fontysrobotics/decentralized_cross_robot_communication_S7_2021_2022/README.md

# decentralized_cross_robot_communication_S7_2021_2022
Here the report, designs, test and code related to the S7 Decentralized cross robot communication
