fontysrobotics/decentralized_cross_robot_communication_S7_2021_2022/PCB/BOM_PCB_PCB_LED_beacon_dcrc_2022-02-03.csv

ID | Name | Designator | Footprint | Quantity | Manufacturer Part | Manufacturer | Supplier | Supplier Part | Price
1 | 1u | C1 | CASE-A_3216 | 1
2 | TC5050RGBF08-3CJH-AF53A | LED1,LED2,LED3,LED4,LED5,LED6,LED7,LED8,LED9,LED10,LED11,LED12,LED13,LED14 | LED-SMD_6P-L5.0-W5.0-TR_TC5050RGBF08 | 14 | TC5050RGBF08-3CJH-AF53A | TCWIN | LCSC | C784540 | 0.039
3 | 25.5 | R1,R2,R3,R4,R5,R6,R7,R8,R9,R14,R11,R12,R13,R10 | R0402 | 14 | 0402WGF255JTCE | Uniroyal Elec | LCSC | C129579 | 0.001
4 | DSIC10LH-P | SW1 | SW-TH_DSIC10LH-P | 1 | DSIC10LH-P | XKB Enterprise | LCSC | C381150 | 0.785
