fontysrobotics/decentralized_cross_robot_communication_S7_2021_2022/PCB/Schematic_PCB_LED_beacon_dcrc_2022-02-03.pdf

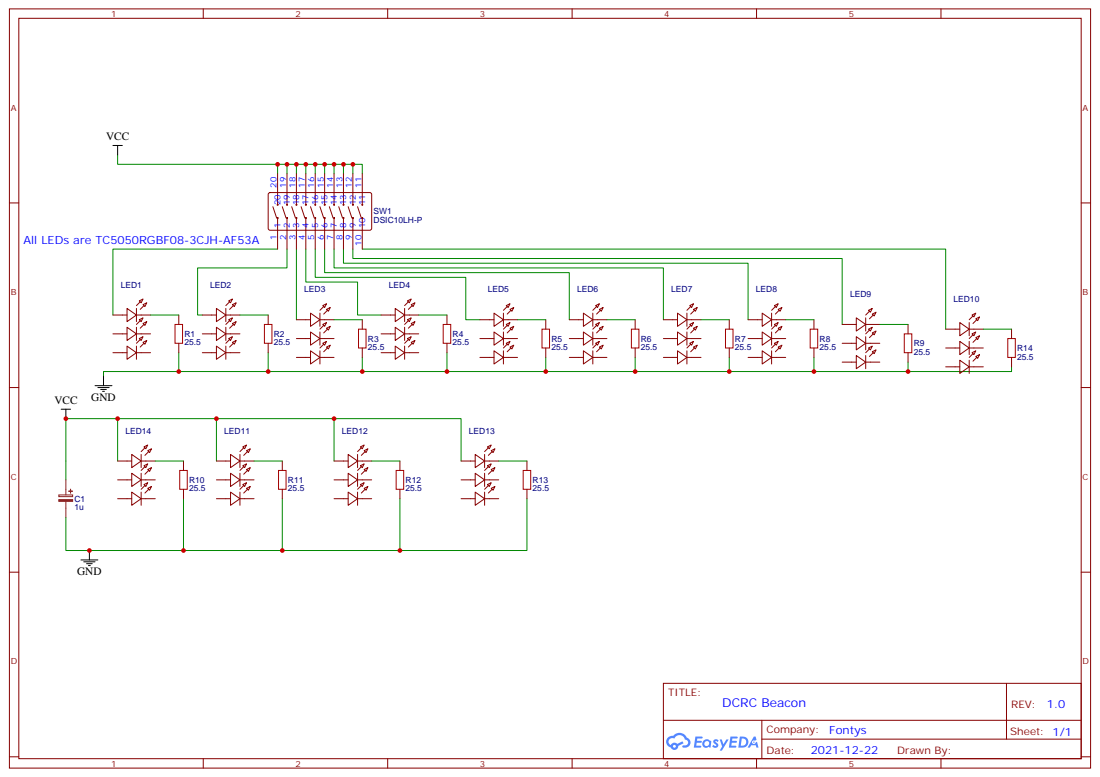
[picture p13: page 1]
