fontysrobotics/decentralized_cross_robot_communication_S7_2021_2022/Case Design/DCRC Case 1.SLDPRT

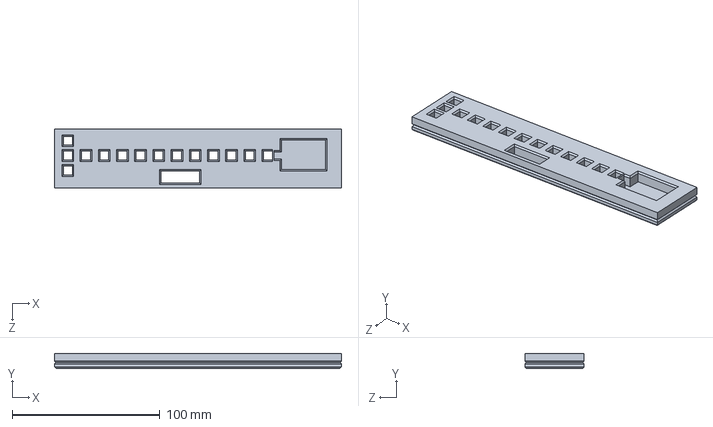
[picture p11: CAD file, 2022-02-03]
Case Design/DCRC Case 1.SLDPRT
194.0 x 10.0 x 40.0 mm
