fontysrobotics/decentralized_cross_robot_communication_S7_2021_2022/Case Design/DCRC Case 2.SLDPRT

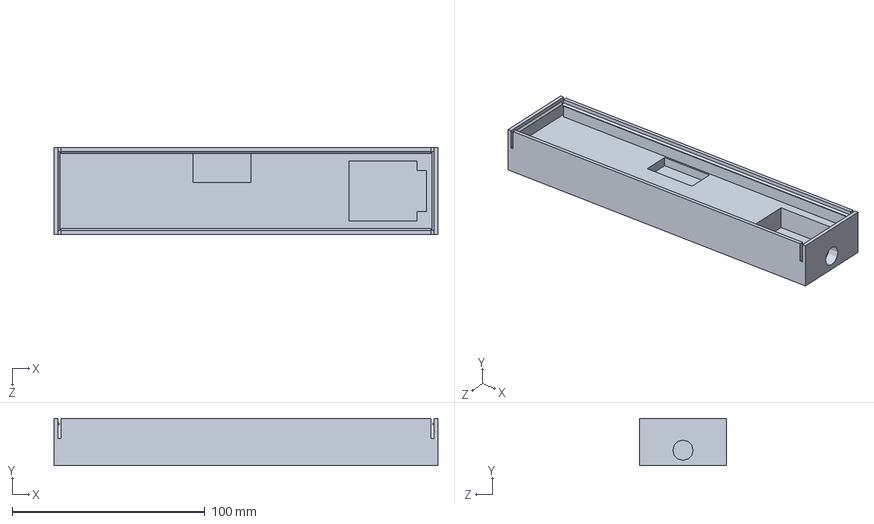
[picture p12: CAD file, 2022-02-03]
Case Design/DCRC Case 2.SLDPRT
199.0 x 24.5 x 45.0 mm
