fontysrobotics/decentralized_cross_robot_communication_S7_2021_2022/(list of files, cad)

Other CAD files:
Case Design/DCRC Case 1.STL
Case Design/DCRC Case 2.STL
